ChristClenson/Automated-Power-Backup/Images/Product.jpeg

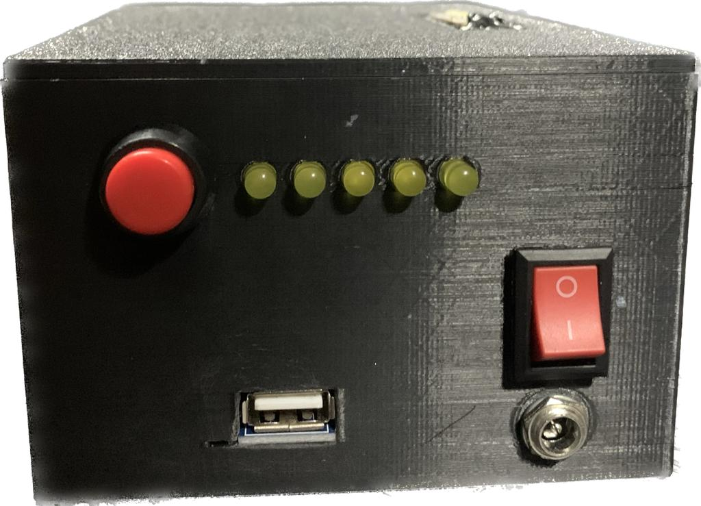
Images/Product.jpeg
