ChristClenson/Automated-Power-Backup/Images/PCB3.png

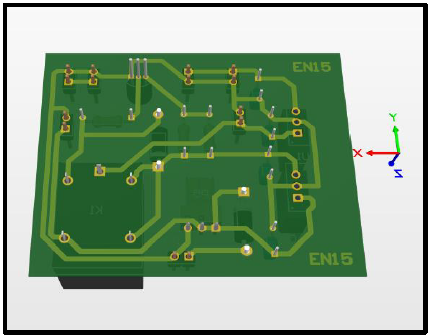
Images/PCB3.png
