ChristClenson/Automated-Power-Backup/Reports/README.md

This directory contains the reports and documentation for the Automated Power Backup project.
