ChristClenson/Automated-Power-Backup/PCB/README.md

This directory contains the Altium design files for the Automated Power Backup project.
