ChristClenson/Automated-Power-Backup/Enclosure/README.md

This directory contains the design files for the enclosure of the Automated Power Backup project.
