ChristClenson/Automated-Power-Backup/Images/Enclosure1.png

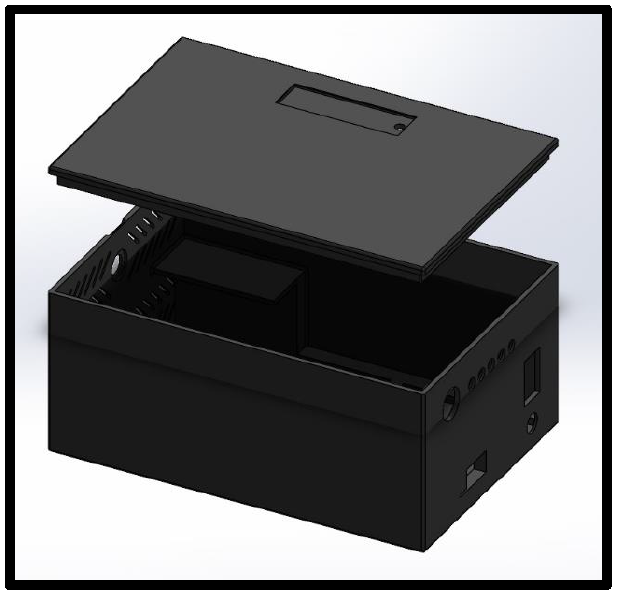
Images/Enclosure1.png
