ChristClenson/Automated-Power-Backup/Images/Enclosure2.png

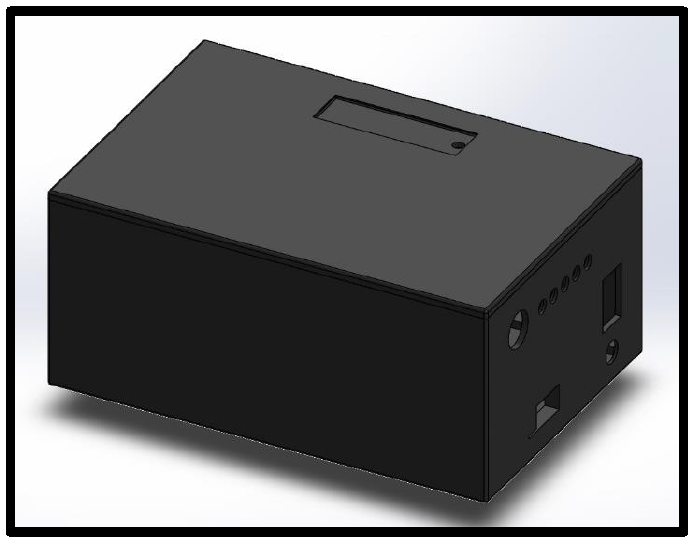
Images/Enclosure2.png
