ChristClenson/Automated-Power-Backup/Images/PCB2.png

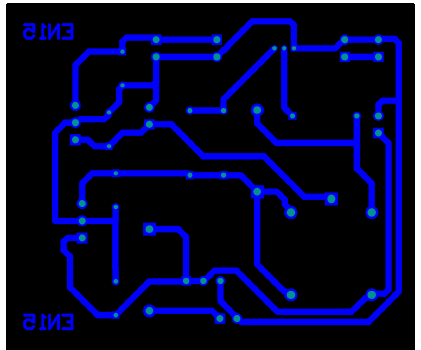
Images/PCB2.png
