ChristClenson/Automated-Power-Backup/Images/PCB4.png

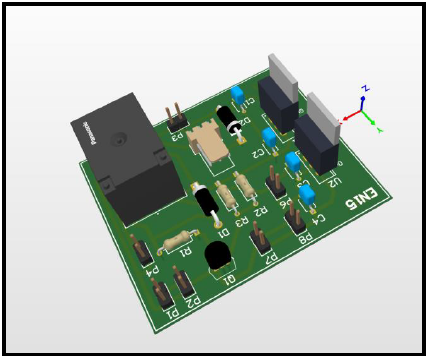
Images/PCB4.png
