ChristClenson/Automated-Power-Backup/Images/PCB.png

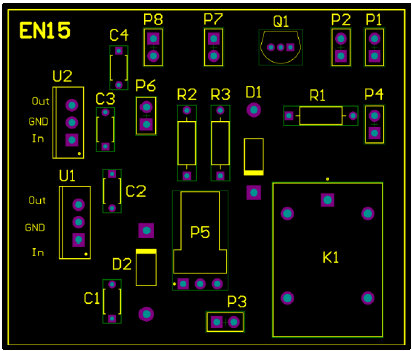
Images/PCB.png
