ChristClenson/Automated-Power-Backup/Images/Schematics.png

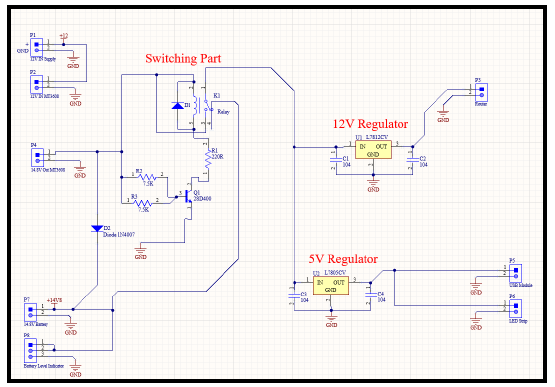
Images/Schematics.png
