ChristClenson/Automated-Power-Backup/Images/Voltage_Regulation_Circuit.png

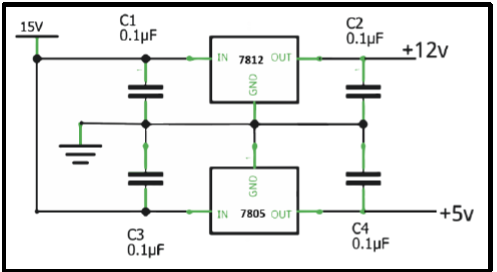
Images/Voltage_Regulation_Circuit.png
