ChristClenson/Automated-Power-Backup/Images/Voltage_Regulator_Model.png

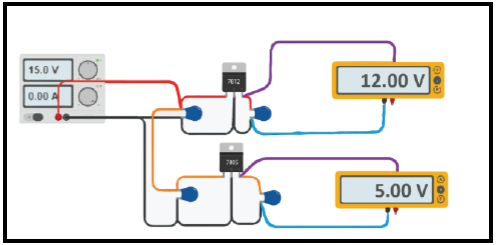
Images/Voltage_Regulator_Model.png
