ChristClenson/Automated-Power-Backup/Enclosure/Assembly_Black.SLDASM

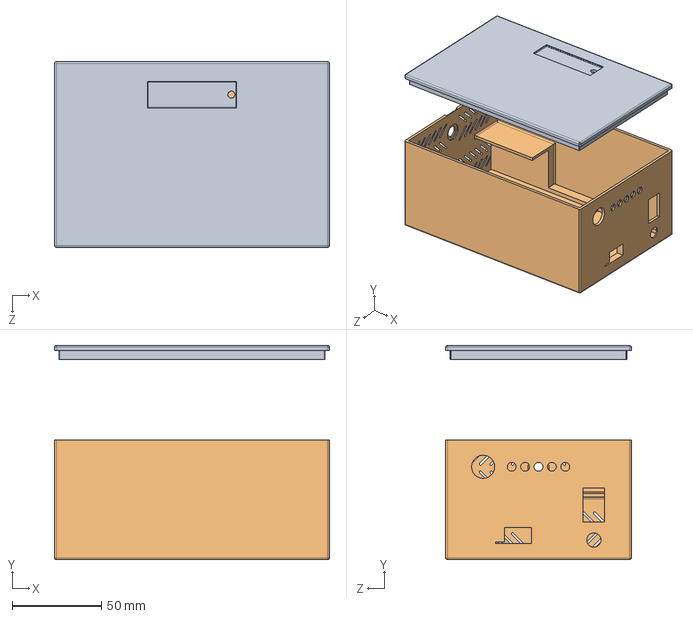
[picture p56: CAD file, 2025-01-12]
Enclosure/Assembly_Black.SLDASM
154.0 x 120.0 x 104.0 mm
Fianl_Lid
Final_Base
