ChristClenson/Automated-Power-Backup/Enclosure/Final_Base_Black.SLDPRT

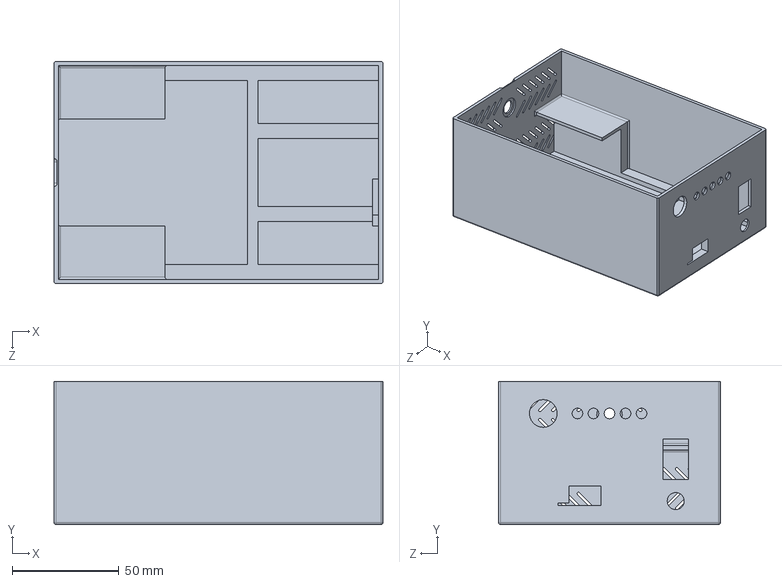
[picture p57: CAD file, 2025-01-12]
Enclosure/Final_Base_Black.SLDPRT
154.0 x 67.0 x 104.0 mm
