ChristClenson/Automated-Power-Backup/Enclosure/Final_Lid_Black.SLDPRT

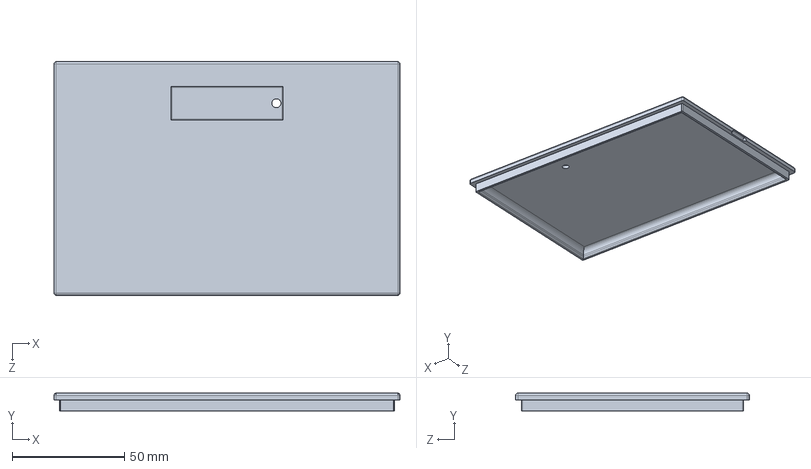
[picture p58: CAD file, 2025-01-12]
Enclosure/Final_Lid_Black.SLDPRT
154.0 x 8.00 x 104.0 mm
