ChristClenson/Automated-Power-Backup/(list of files, drawings)

Other design files:
PCB/design project EN15.PrjPcb
PCB/PCB EN 15.PcbDoc
PCB/schematic EN15.SchDoc
