ChristClenson/Automated-Power-Backup/(commit log)

2025-01-12 Added the SolidWorks Design Files
    [Assembly_Black.SLDASM, Final_Base_Black.SLDPRT, Final_Lid_Black.SLDPRT]
2025-01-12 Added the Altium Design Files of the PCB
    [PCB EN 15.PcbDoc, design project EN15.PrjPcb, schematic EN15.SchDoc]
